jvanvalkenburgh/vibraphone-controller/adams-controller/2023-11-19-210502.jpg

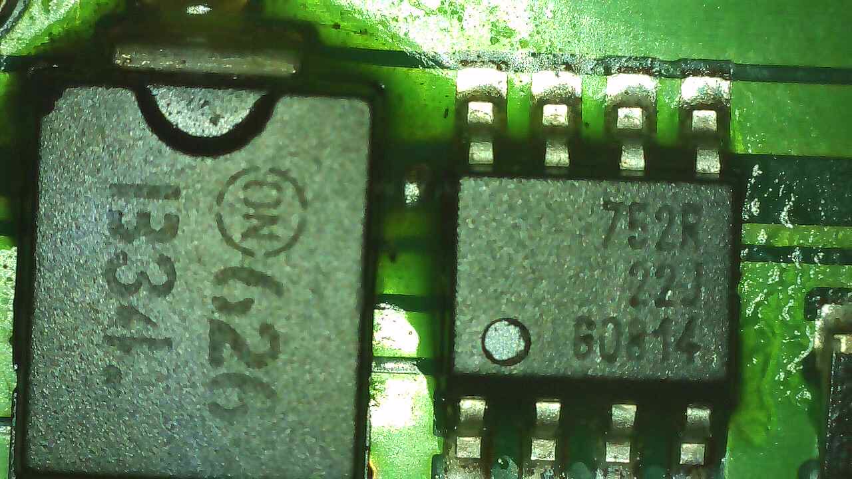
adams-controller/2023-11-19-210502.jpg
