jvanvalkenburgh/vibraphone-controller/adams-controller/README.md

# Adams Vibraphone 

This directory contains photos of the Adams board and datasheets on identfied ICs.
