jvanvalkenburgh/vibraphone-controller/docs/ref/REFERENCES.md

# Reference Designs / Ideas

MAX7219 - https://app.ultralibrarian.com/m/Analog-Devices-Inc/rd/MAXREFDES99
