jvanvalkenburgh/vibraphone-controller/adams-controller/2023-11-19-210343.jpg

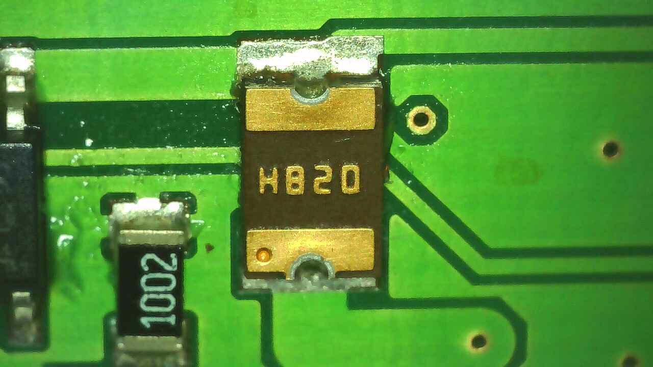
adams-controller/2023-11-19-210343.jpg
