jvanvalkenburgh/vibraphone-controller/adams-controller/2023-11-19-210358.jpg

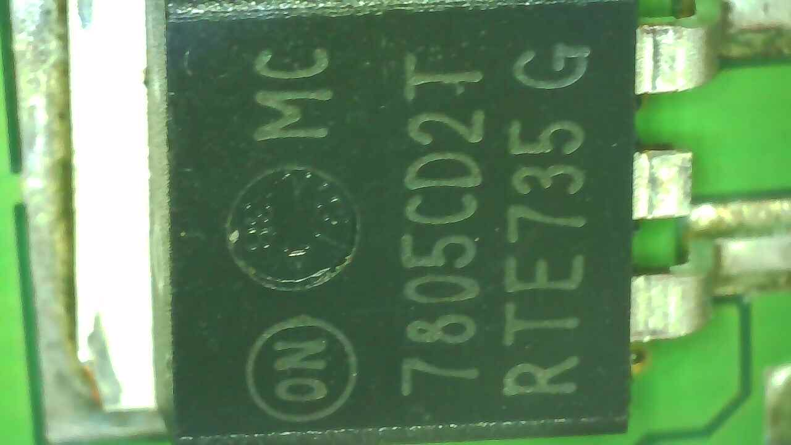
adams-controller/2023-11-19-210358.jpg
