jvanvalkenburgh/vibraphone-controller/adams-controller/2023-11-19-210453.jpg

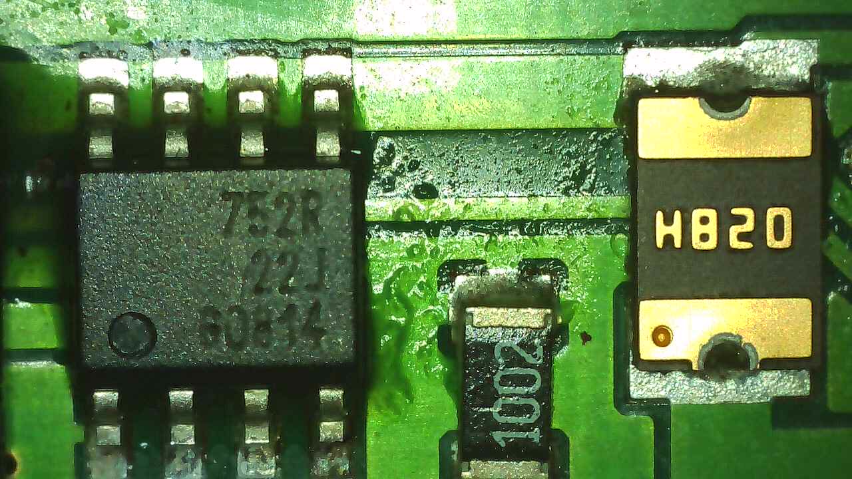
adams-controller/2023-11-19-210453.jpg
