jvanvalkenburgh/vibraphone-controller/adams-controller/2023-11-19-210553.jpg

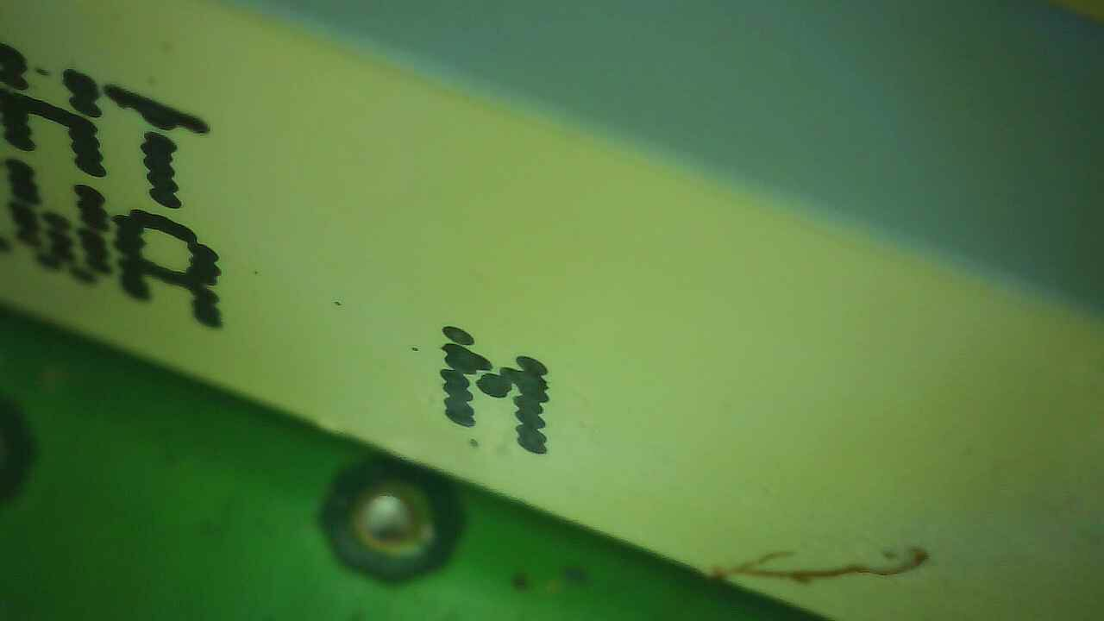
adams-controller/2023-11-19-210553.jpg
