jvanvalkenburgh/vibraphone-controller/adams-controller/2023-11-19-210631.jpg

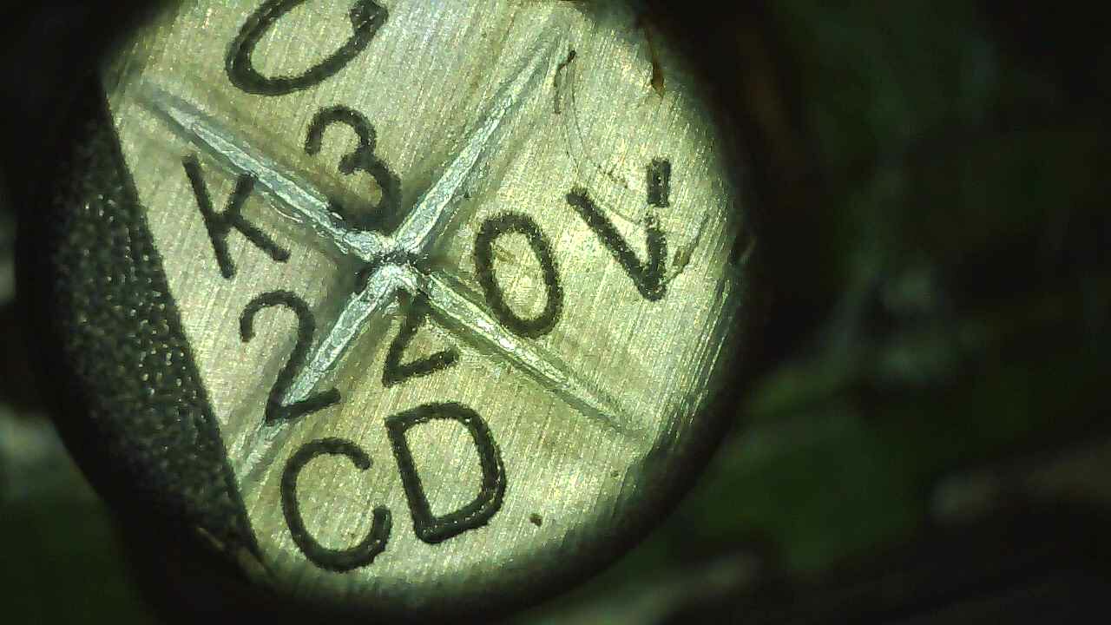
adams-controller/2023-11-19-210631.jpg
