jvanvalkenburgh/vibraphone-controller/cad/Power_Proto_PCB.png

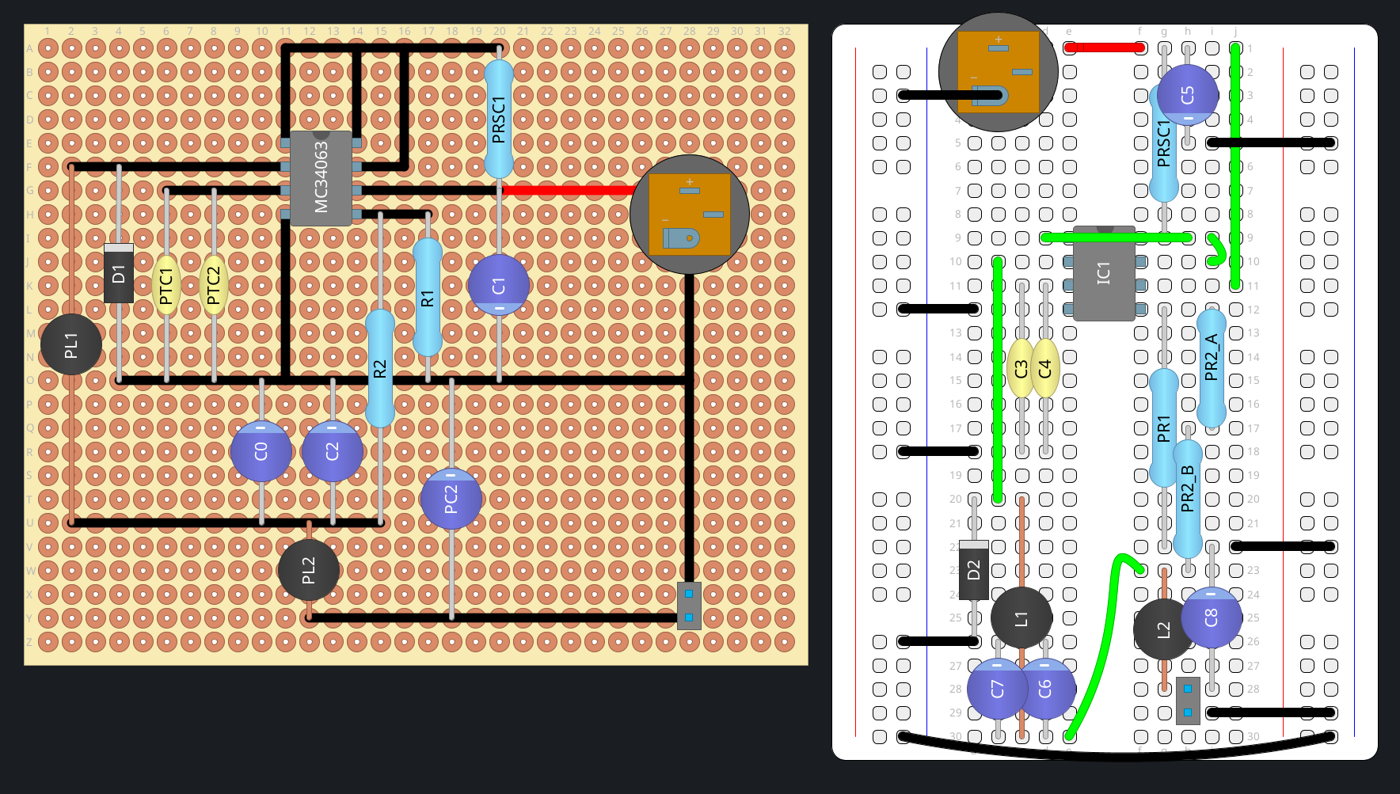
cad/Power_Proto_PCB.png
