jvanvalkenburgh/vibraphone-controller/cad/PCB.ods

 | TC1 | TC2 | D1 | L1 | C0 | Ifilter | Cfilter |  |  |  |  | Rsc | C1 | R2 | R1 | JaCK | Wire
Spacing |  |  |  | 2 |  | 2
Rail
Vp |  |  |  |  |  |  |  | u1 | u | u | u8 |  |  |  |  |  | S | Vp
R2 |  |  | s | s |  |  |  | u2 | x |  | u7 | E |  |  |  |  | E | Vp
r1 | S | S |  |  |  |  |  | u3 |  | x | u6 | S | S |  |  | s |  | vin
GND |  |  |  |  |  |  |  | u4 |  | x | u5 |  |  | s | s |  |  | R4
R3 |  |  |  | e | s | s |  |  |  |  |  |  |  | e
Vout |  |  |  |  |  | e | s
GND | e | e | e |  | e |  | e |  |  |  |  |  | e |  | e | E
