jvanvalkenburgh/vibraphone-controller/3d/AA3528-015.step

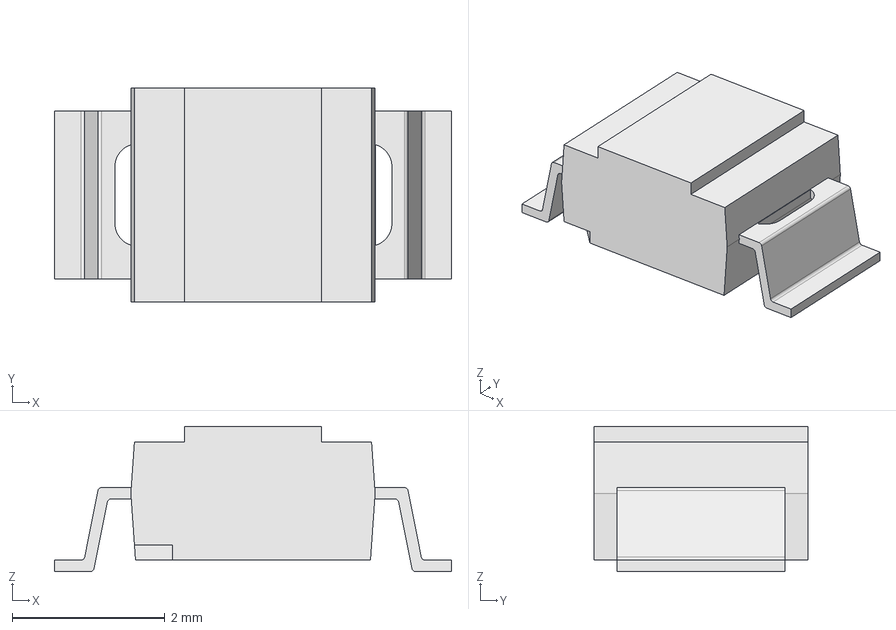
[picture p17: CAD file, 2024-11-24]
3d/AA3528-015.step
5.20 x 2.80 x 1.90 mm
AA3528-09
AA3528-010
AA3528-011
AA3528-012
AA3528-013
AA3528-014
