jvanvalkenburgh/vibraphone-controller/3d/RS6011YA6009.stp

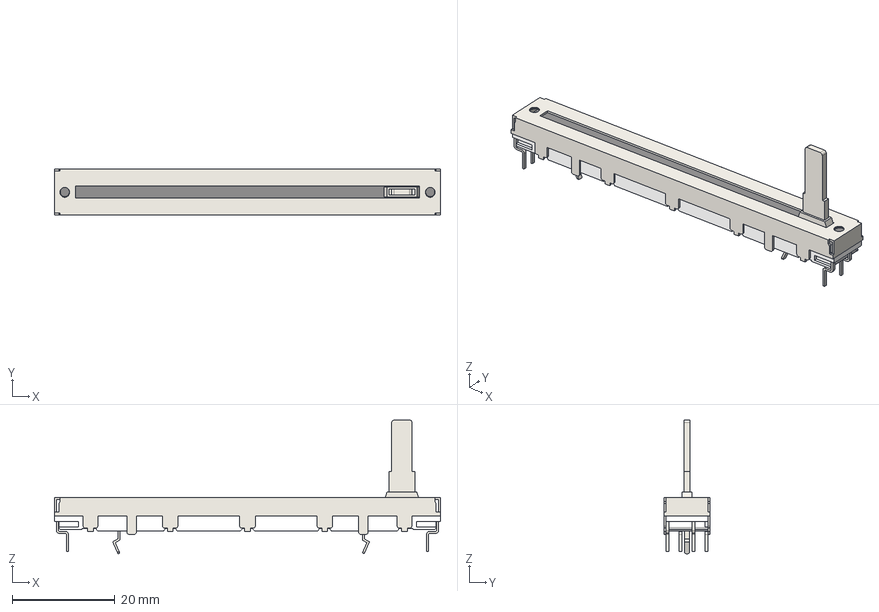
[picture p18: CAD file, 2024-11-24]
3d/RS6011YA6009.stp
75.0 x 9.00 x 26.0 mm
