jvanvalkenburgh/vibraphone-controller/3d/BA56-12EWA.step

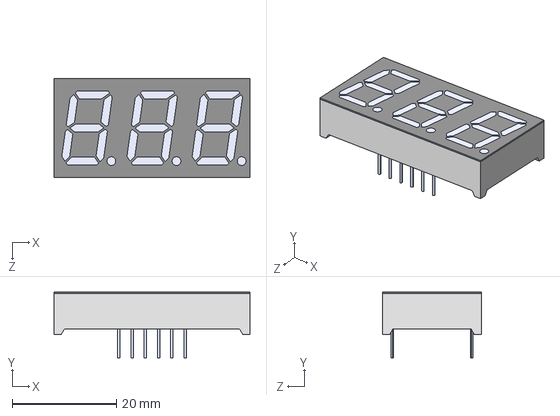
[picture p19: CAD file, 2024-11-24]
3d/BA56-12EWA.step
37.6 x 12.6 x 19.0 mm
