jvanvalkenburgh/vibraphone-controller/3d/1-1571994-0.stp

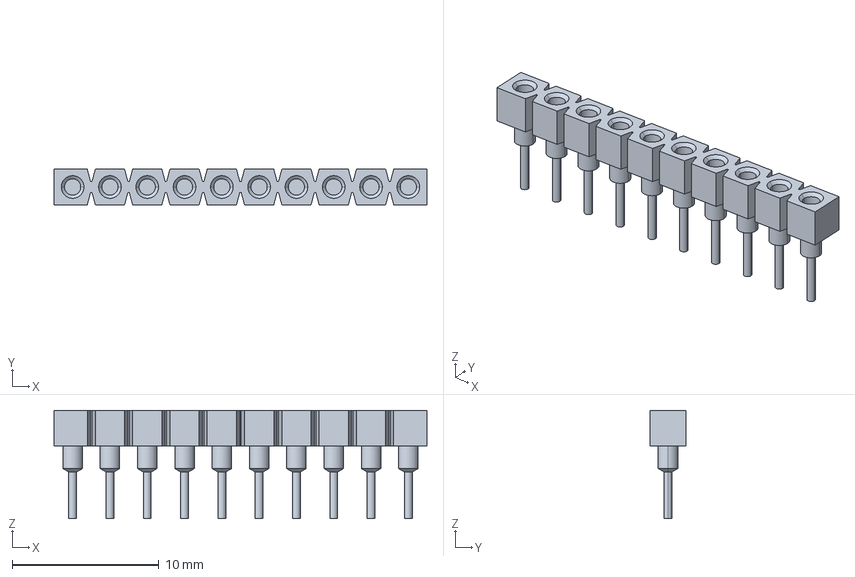
[picture p20: CAD file, 2024-11-24]
3d/1-1571994-0.stp
25.4 x 2.44 x 7.37 mm
