jvanvalkenburgh/vibraphone-controller/3d/motor-flange.3mf

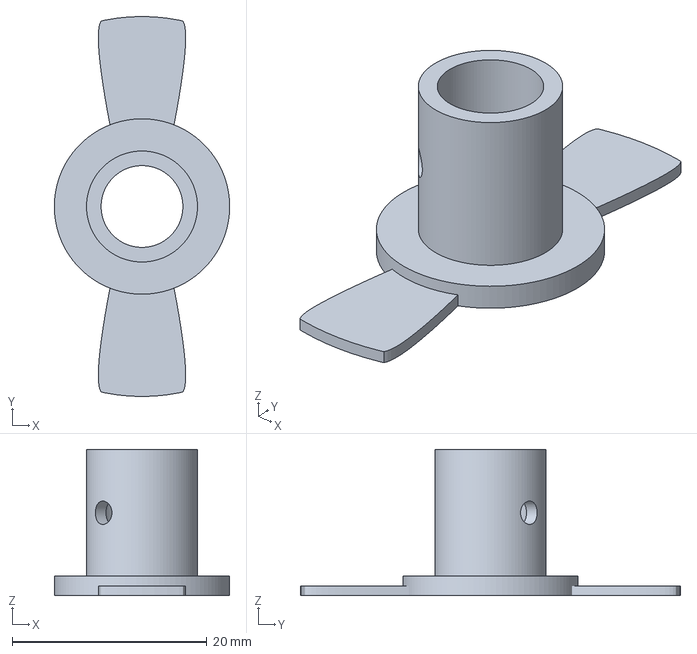
[picture p21: CAD file, 2024-11-11]
3d/motor-flange.3mf
18.0 x 39.0 x 15.0 mm
