jvanvalkenburgh/vibraphone-controller/3d/roller-bearing-support-1f.3mf

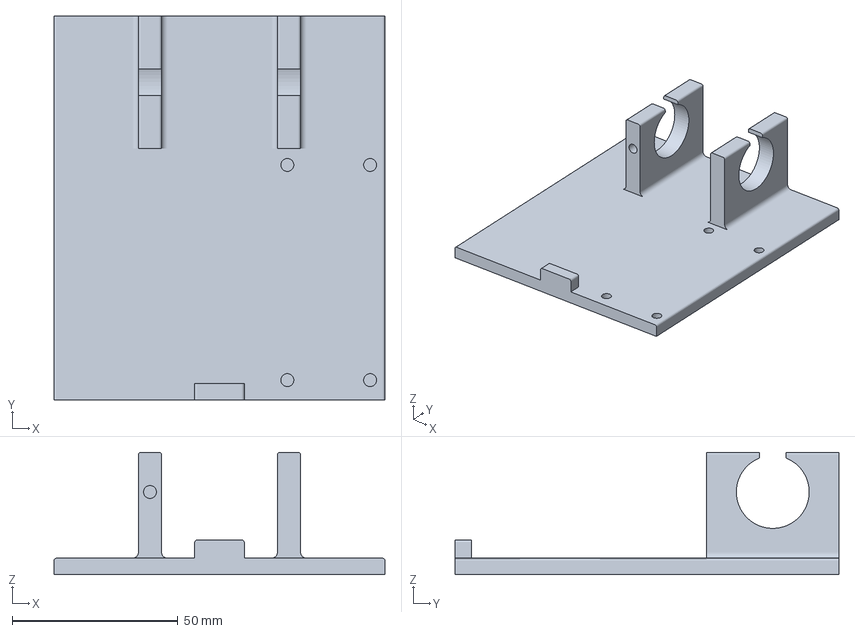
[picture p22: CAD file, 2024-11-11]
3d/roller-bearing-support-1f.3mf
100.0 x 116.0 x 37.0 mm
