jvanvalkenburgh/vibraphone-controller/(list of files, cad)

Other CAD files:
cad/motor-flange.stl
cad/roller-bearing-support-1f.stl
