jvanvalkenburgh/vibraphone-controller/VibraphonePCB/power.kicad_sch

## KiCad design VibraphonePCB/power.kicad_sch (2024-11-19)

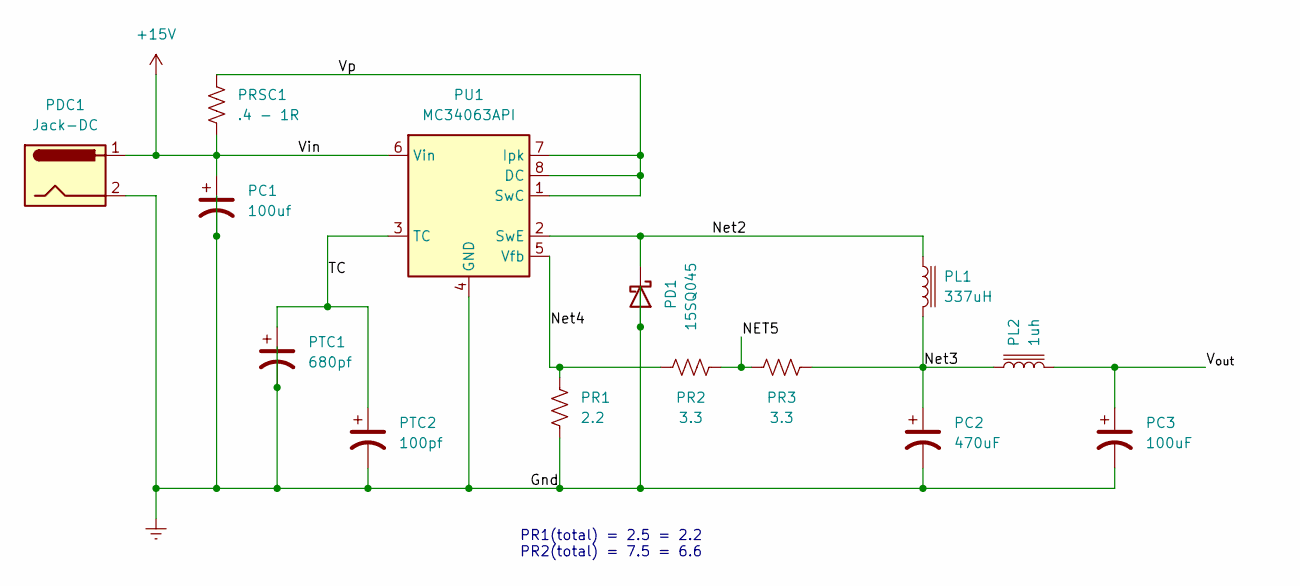
[picture p24: schematic power.kicad_sch]

Parts:
PC1: 100uf
PC2: 470uF
PC3: 100uF
PD1: 15SQ045
PDC1: Jack-DC
PL1: 337uH
PL2: 1uh
PR1: 2.2
PR2, PR3: 3.3
PRSC1: .4 - 1R
PTC1: 680pf
PTC2: 100pf
PU1: MC34063API; DIP-8_W7.62mm

Connections:
+15V: PC1.1, PDC1.1, PRSC1.2, PU1.6 (Vin)
Earth: PC1.2, PC2.2, PC3.2, PD1.2 (A), PDC1.2, PR1.2, PTC1.2, PTC2.2, PU1.4 (GND)
NET5: PR2.2, PR3.1
Net2: PD1.1 (K), PL1.1, PU1.2 (SwE)
Net3: PC2.1, PL1.2, PL2.1, PR3.2
Net4: PR1.1, PR2.1, PU1.5 (Vfb)
TC: PTC1.1, PTC2.1, PU1.3 (TC)
V_{out}: PC3.1, PL2.2
Vp: PRSC1.1, PU1.1 (SwC), PU1.7 (Ipk), PU1.8 (DC)

Notes on the sheet:
PR1(total) = 2.5 = 2.2 PR2(total) = 7.5 = 6.6
