jvanvalkenburgh/vibraphone-controller/cad/vibraphone-controller.kicad_sch

## KiCad design cad/vibraphone-controller.kicad_sch (2024-11-19)

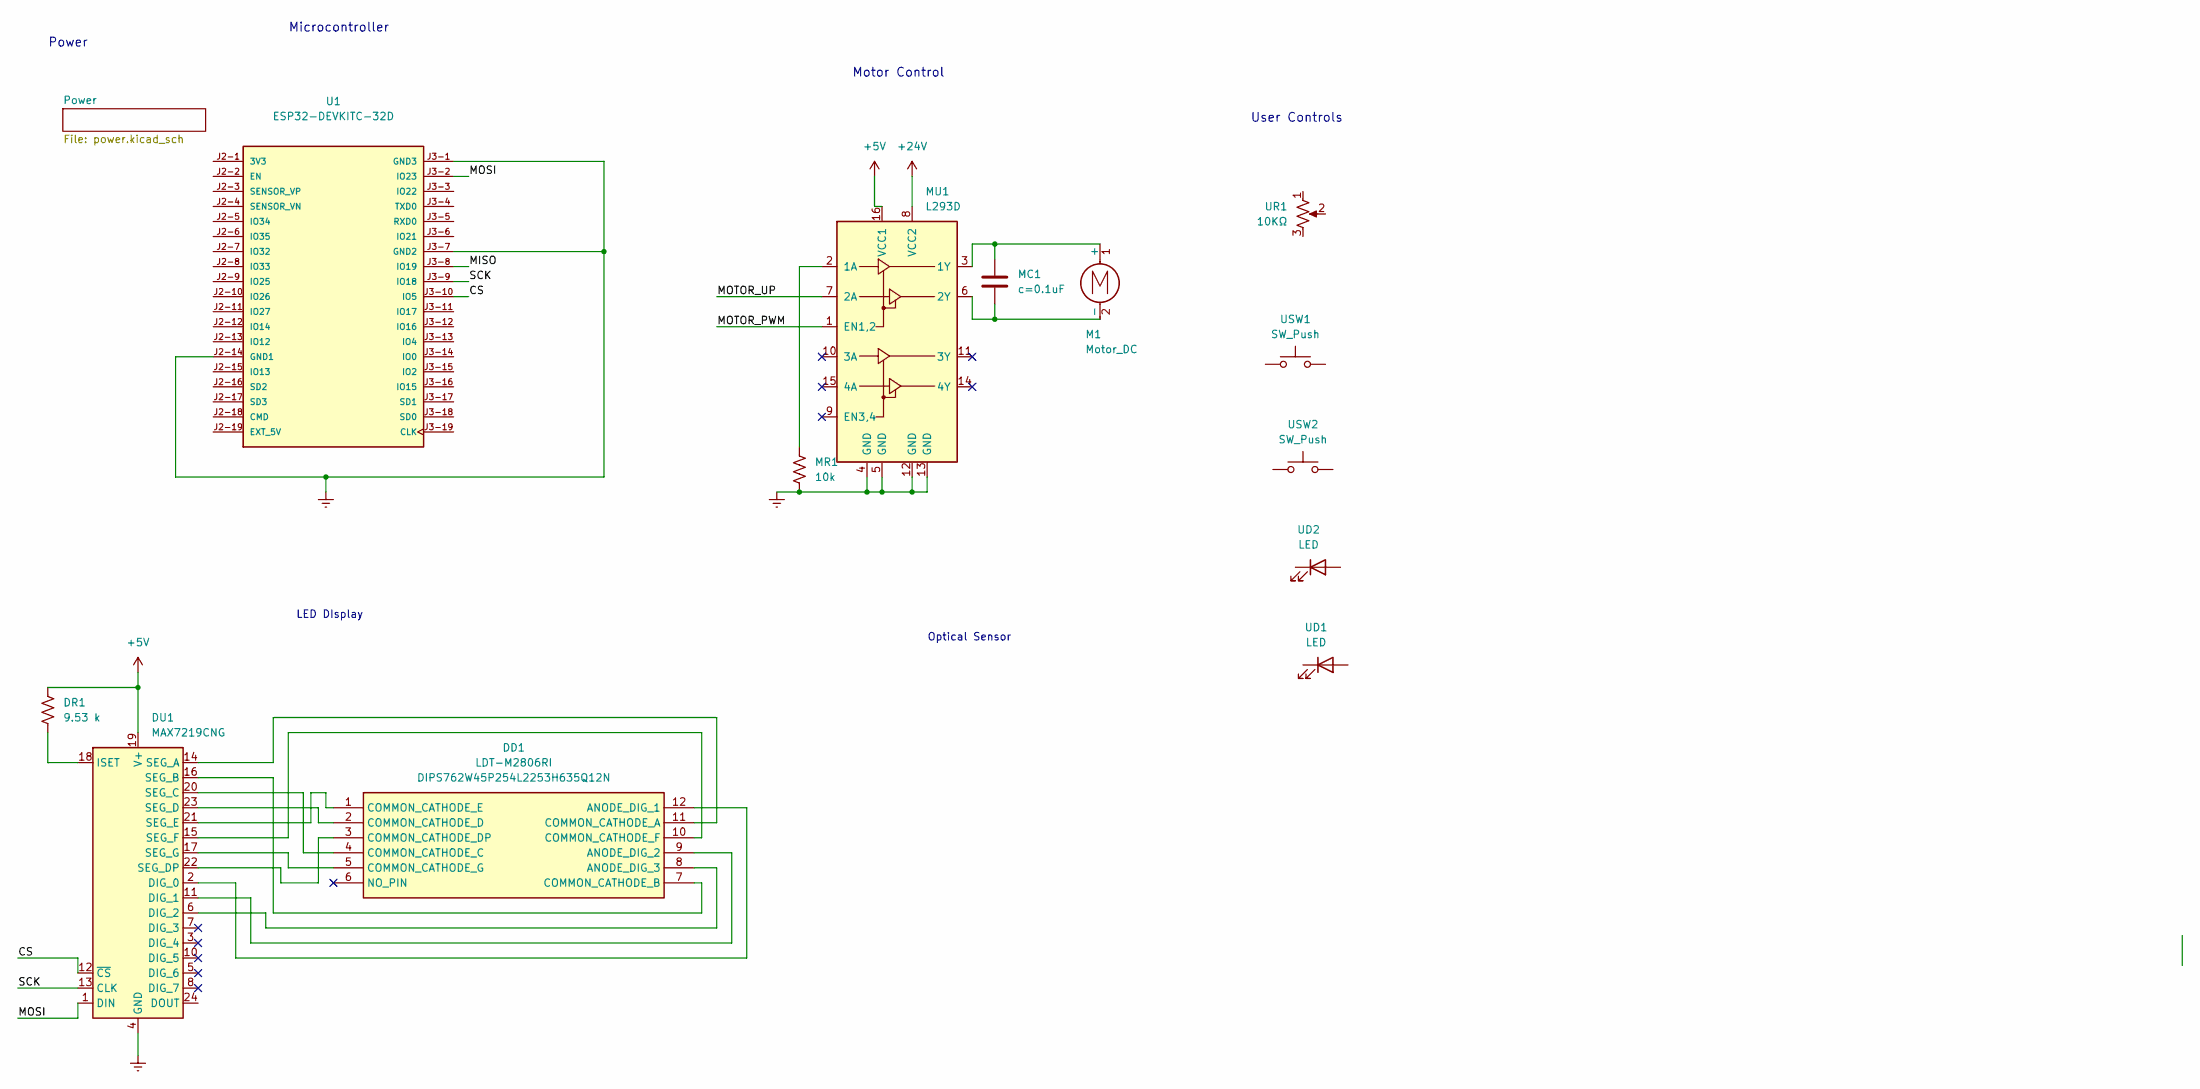
[picture p25: schematic vibraphone-controller.kicad_sch]

Parts:
DD1: LDT-M2806RI; DIPS762W45P254L2253H635Q12N; Manufacturer_Part_Number LDT-M2806RI; Mouser Part Number 696-LDT-M2806RI
DR1: 9.53 k
DU1: MAX7219CNG; DIP-24_W7.62mm
M1: Motor_DC
MC1: c=0.1uF
MR1: 10k
MU1: L293D; DIP-16_W7.62mm
U1: ESP32-DEVKITC-32D; MODULE_ESP32-DEVKITC-32D; PARTREV V4
UD1, UD2: LED
UR1: 10KΩ
USW1, USW2: SW_Push

Connections:
+5V: DR1.1, DU1.19 (V+), MU1.16 (VCC1)
+24V: MU1.8 (VCC2)
CS: DU1.12 (~CS), U1.J3-10 (IO5)
Earth: DU1.4 (GND), DU1.9 (GND), MR1.2, MU1.4 (GND), MU1.5 (GND), MU1.12 (GND), MU1.13 (GND), U1.J2-14 (GND1), U1.J3-1 (GND3), U1.J3-7 (GND2)
MISO: U1.J3-8 (IO19)
MOSI: DU1.1 (DIN), U1.J3-2 (IO23)
MOTOR_PWM: MU1.1 (EN1,2)
MOTOR_UP: MU1.7 (2A)
unnamed: DD1.1 (COMMON_CATHODE_E), DU1.21 (SEG_E)
unnamed: DD1.2 (COMMON_CATHODE_D), DU1.23 (SEG_D)
unnamed: DD1.3 (COMMON_CATHODE_DP), DU1.22 (SEG_DP)
unnamed: DD1.4 (COMMON_CATHODE_C), DU1.20 (SEG_C)
unnamed: DD1.5 (COMMON_CATHODE_G), DU1.17 (SEG_G)
unnamed: DD1.7 (COMMON_CATHODE_B), DU1.16 (SEG_B)
unnamed: DD1.8 (ANODE_DIG_3), DU1.6 (DIG_2)
unnamed: DD1.9 (ANODE_DIG_2), DU1.11 (DIG_1)
unnamed: DD1.10 (COMMON_CATHODE_F), DU1.15 (SEG_F)
unnamed: DD1.11 (COMMON_CATHODE_A), DU1.14 (SEG_A)
unnamed: DD1.12 (ANODE_DIG_1), DU1.2 (DIG_0)
unnamed: DR1.2, DU1.18 (ISET)
unnamed: M1.1 (+), MC1.1, MU1.3 (1Y)
unnamed: M1.2 (-), MC1.2, MU1.6 (2Y)
unnamed: MR1.1, MU1.2 (1A)
SCK: DU1.13 (CLK), U1.J3-9 (IO18)

Notes on the sheet:
LED DIsplay
Power
Microcontroller
Motor Control
Optical Sensor
User Controls
