jvanvalkenburgh/vibraphone-controller/(commit log)

2023-12-16 Prototype info
2024-11-05 add arduino code
2024-11-15 Added KiCad PCB Files
    [VibraphonePCB.kicad_pcb, VibraphonePCB.kicad_sch, power.kicad_sch]
2024-11-19 Updated Schematics
    [VibraphonePCB.kicad_pcb, VibraphonePCB.kicad_sch, led.kicad_sch, motor-flange.scad, power.kicad_sch, prototype-motor-mount.scad, untitled.kicad_sch, vibraphone-controller.csv]
2024-11-24 added 3D files for PCB
    [1-1571994-0.stp, AA3528-015.step, BA56-12EWA.step, RS6011YA6009.stp, VibraphonePCB.kicad_pcb]
